GIT-PROTONU/LBV1/LBV1.pdf

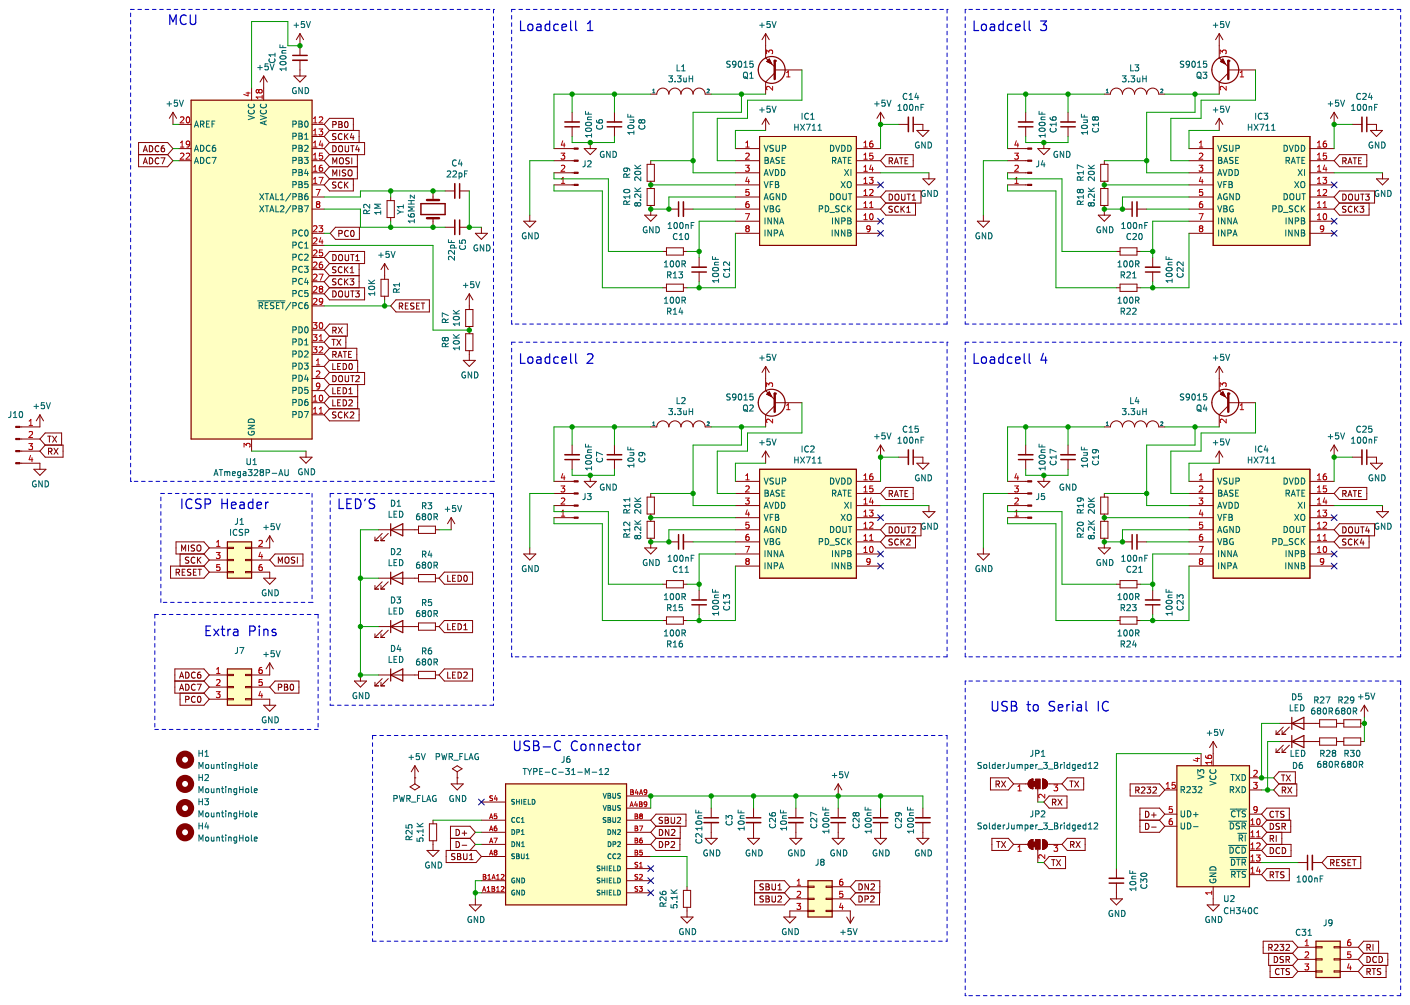
[picture p3: page 1]
