GIT-PROTONU/LBV1/(commit log)

2026-04-23 Initial commit — LBV1 4-channel load cell monitor v1.3
    Arduino Nano firmware (LBV1.ino):
    - 4x HX711 load cells with EEPROM-backed calibration
    - Integer serial output x100 for fast AVR throughput
    - Per-channel ready flags, diag mode, tare, live cal adjust
    Web UI (index.html):
    - Web Serial API, no server required
    - Real-time Chart.js visualisation with requestAnimationFrame
    - Cal value readouts, Hz counter, diag/normal mode toggle
2026-04-23 Add hardware schematic PDF
2026-04-23 Add full feature set — v1.4 firmware + expanded web UI
    Firmware:
    - Line-buffered serial parser for multi-char commands
    - Per-channel tare (t0-t3), guided calibration (k<ch>:<mass>)
    - Overload thresholds in EEPROM (o<ch>:<val>), OVL: packets, LED2 blink
    - THR: packet on connect, CAL:/THR: both sent on 'c' command
    Website:
    - Min/max tracking per channel, reset on tare
    - Overload card highlight with animation
    - Per-channel chart show/hide toggles + y-axis lock
    - Overload threshold inputs synced to firmware
    - Record/stop + CSV export with timestamps
    - Calibration wizard modal (tare -> countdown -> known mass -> confirm)
    [LBV1.ino]
2026-04-23 Improve calibration UX — direct entry, step selector, scroll wheel
    Firmware: add v<ch>:<val> command to set cal factor directly
    Website: replace +/- buttons with step-size selector (1/10/100/1k),
    stacked arrow buttons, and scroll-wheel support on cal inputs
    [LBV1.ino]
2026-04-23 v1.5: sampling config, auto-tare, sum channel, baseline/drift, dark/light theme, keyboard shortcuts, EMA smoothing, time window slider
    [LBV1.ino]
2026-04-24 Redesign web UI with PROTONU brand identity
    Apply styles.css from protonu.com — PROTONU red logo box nav, near-black
    background, red accent color, grain noise overlay, scroll progress bar,
    and glass-card components. Remove light/dark theme toggle.
2026-06-13 Add Balance tab showing center of pressure on the plate
    New tab visualises where the combined weight sits as a moving dot on a
    square plate, computed as the load-weighted average of the four corner
    positions. Includes configurable corner-to-load-cell mapping, X/Y offset
    and off-center readouts, live force per corner, a fading trail, and a
    min-load deadzone. Negative readings are clamped to zero.
